briansvr/esp32s3_adc_mini/esp32s3_adc_mini/.step

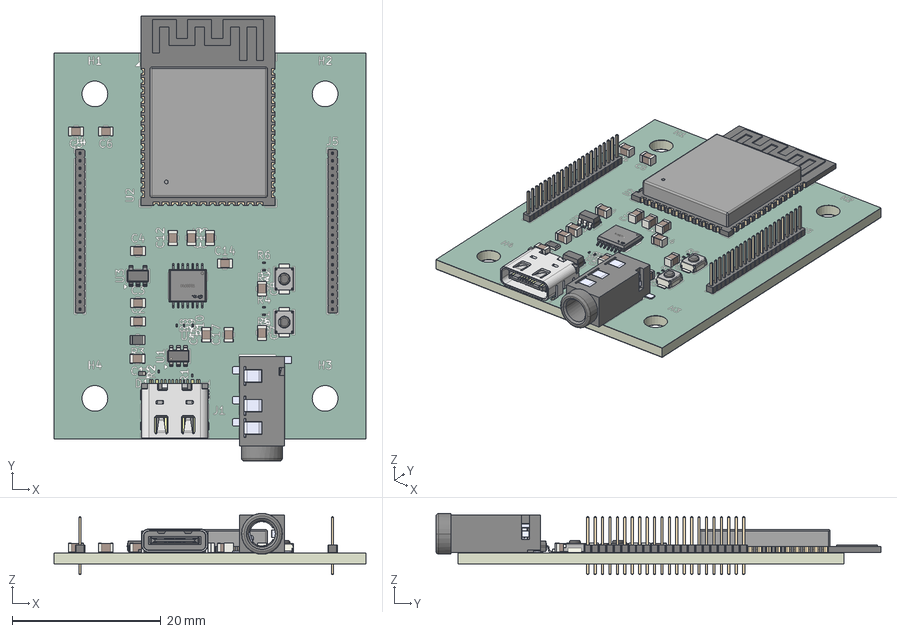
[picture p1: CAD file, 2026-05-14]
esp32s3_adc_mini/.step
42.0 x 59.9 x 8.25 mm
SOT-23-6
R_01005_0402Metric x 9
C_0805_2012Metric x 14
AUDIO-SMD_PJ-320D-1
SW_SPST_B3U-1000P x 2
SOT-23-5
PinHeader_1x22_P1.00mm_Vertical x 2
USB-C-SMD_G-SWITCH_GT-USB-7010ASV
D_SOD-882D
R_0805_2012Metric
TSSOP-14_L5.0-W4.4-H1.0-LS6.4-P0.65
ESP32-S3-WROOM-1
esp32s3_adc_mini_silkscreen
esp32s3_adc_mini_soldermask x 2
esp32s3_adc_mini_PCB
