briansvr/esp32s3_adc_mini/(list of files, cad)

Other CAD files:
esp32s3_adc_mini/.stl
esp32s3_adc_mini_bat/.stl
