briansvr/esp32s3_adc_mini/esp32s3_adc_mini_bat/esp32s3_adc_mini_bat.kicad_pcb

## KiCad design esp32s3_adc_mini_bat/esp32s3_adc_mini_bat.kicad_pcb (2026-09-10)

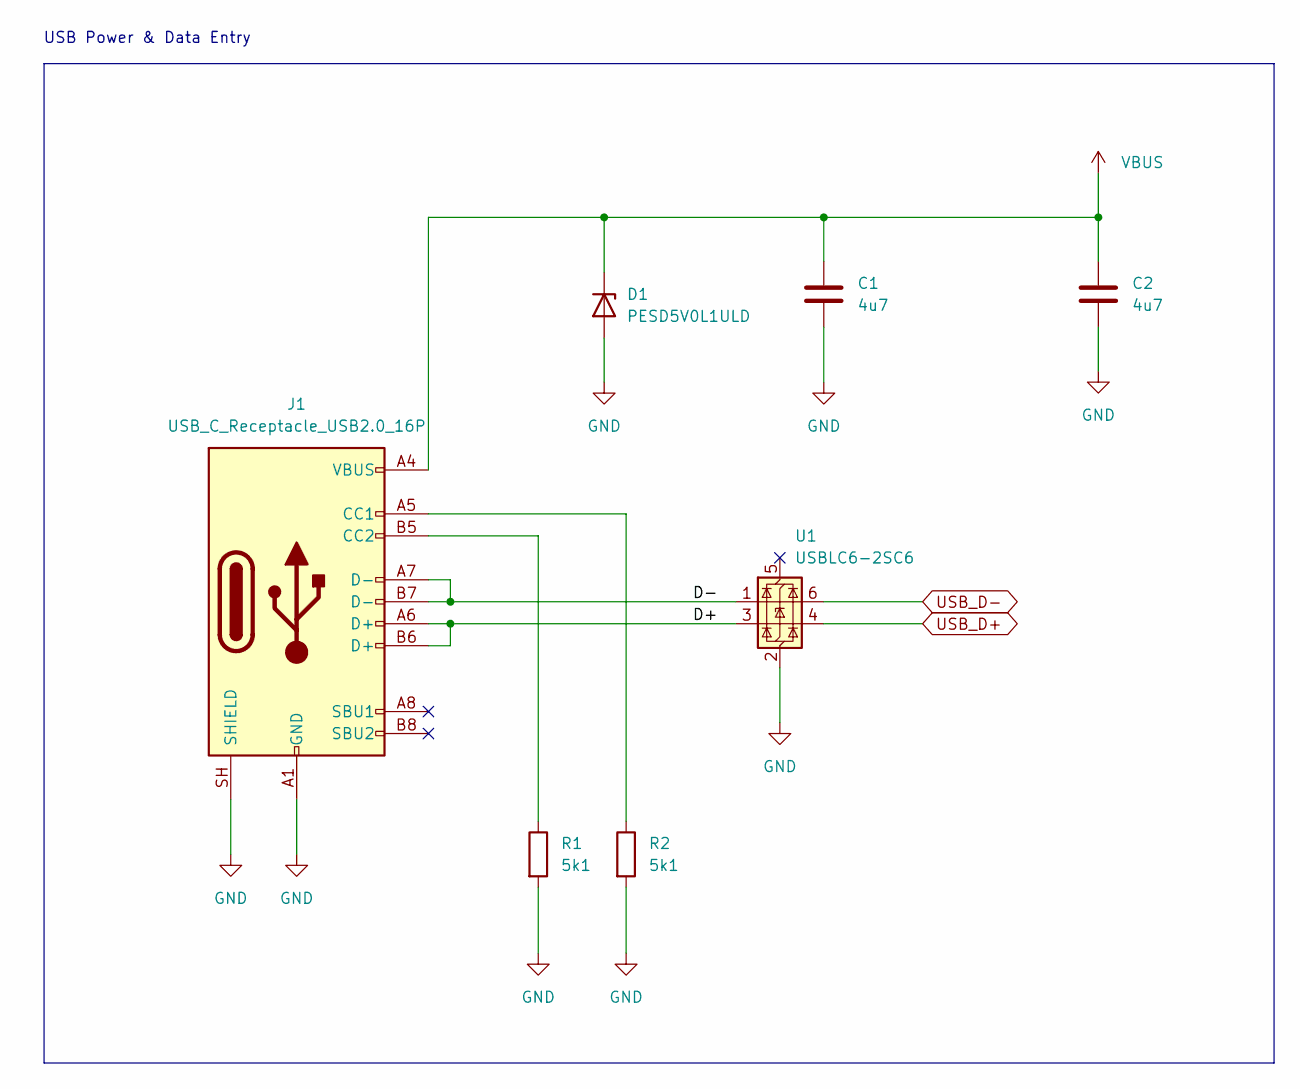
[picture p2: schematic USB_ENTRY.kicad_sch]

Parts:
C1, C2: 4u7; C_0805_2012Metric
D1: PESD5V0L1ULD; D_SOD-882D
J1: USB_C_Receptacle_USB2.0_16P; USB_C_Receptacle_G-Switch_GT-USB-7010ASV
R1, R2: 5k1; R_0402_1005Metric
U1: USBLC6-2SC6; SOT-23-6

Connections:
/USB_ENTRY/D+: J1.A6 (D+), J1.B6 (D+), U1.3 (I/O2)
/USB_ENTRY/D-: J1.A7 (D-), J1.B7 (D-), U1.1 (I/O1)
GND: C1.2, C2.2, D1.2 (A), J1.A1 (GND), J1.A12 (GND), J1.B1 (GND), J1.B12 (GND), J1.SH (SHIELD), R1.2, R2.2, U1.2 (GND); also elsewhere on the board
unnamed: J1.A5 (CC1), R2.1
unnamed: J1.B5 (CC2), R1.1
USB_D+: U1.4 (I/O2); also elsewhere on the board
USB_D-: U1.6 (I/O1); also elsewhere on the board
VBUS: C1.1, C2.1, D1.1 (K), J1.A4 (VBUS), J1.A9 (VBUS), J1.B4 (VBUS), J1.B9 (VBUS); also elsewhere on the board

Notes on the sheet:
USB Power & Data Entry

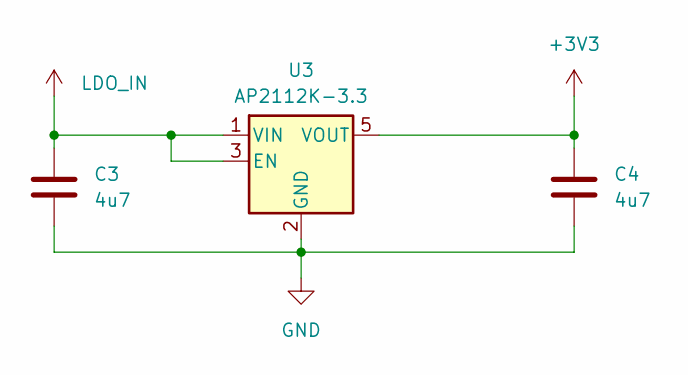
[picture p3: schematic VBUSLDO.kicad_sch]

Parts:
C3, C4: 4u7; C_0805_2012Metric
U3: AP2112K-3.3; SOT-23-5

Connections:
+3V3: C4.1, U3.5 (VOUT); also elsewhere on the board
GND: C3.2, C4.2, U3.2 (GND); also elsewhere on the board
LDO_IN: C3.1, U3.1 (VIN), U3.3 (EN); also elsewhere on the board

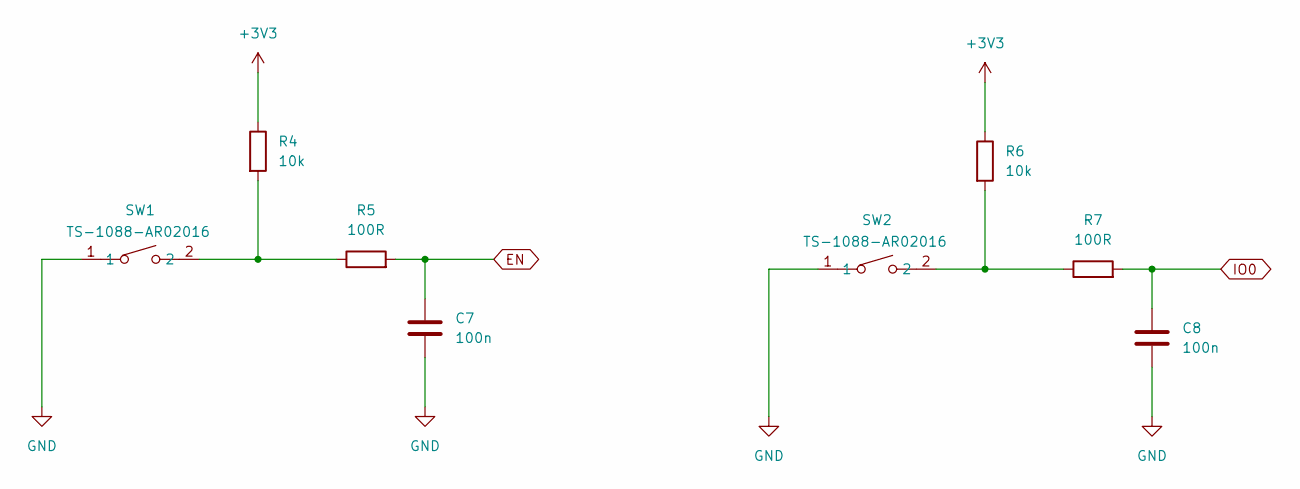
[picture p4: schematic BTNS.kicad_sch]

Parts:
C7, C8: 100n; C_0805_2012Metric
R4, R6: 10k; R_0402_1005Metric
R5, R7: 100R; R_0402_1005Metric
SW1, SW2: TS-1088-AR02016; SW-SMD_L3.9-W3.0-P4.45; MPN TS-1088-AR02016; LCSC Part C720477

Connections:
+3V3: R4.1, R6.1; also elsewhere on the board
EN: C7.1, R5.2; also elsewhere on the board
GND: C7.2, C8.2, SW1.1, SW2.1; also elsewhere on the board
IO0: C8.1, R7.2; also elsewhere on the board
unnamed 47: R4.2, R5.1, SW1.2; also elsewhere on the board
unnamed 48: R6.2, R7.1, SW2.2; also elsewhere on the board

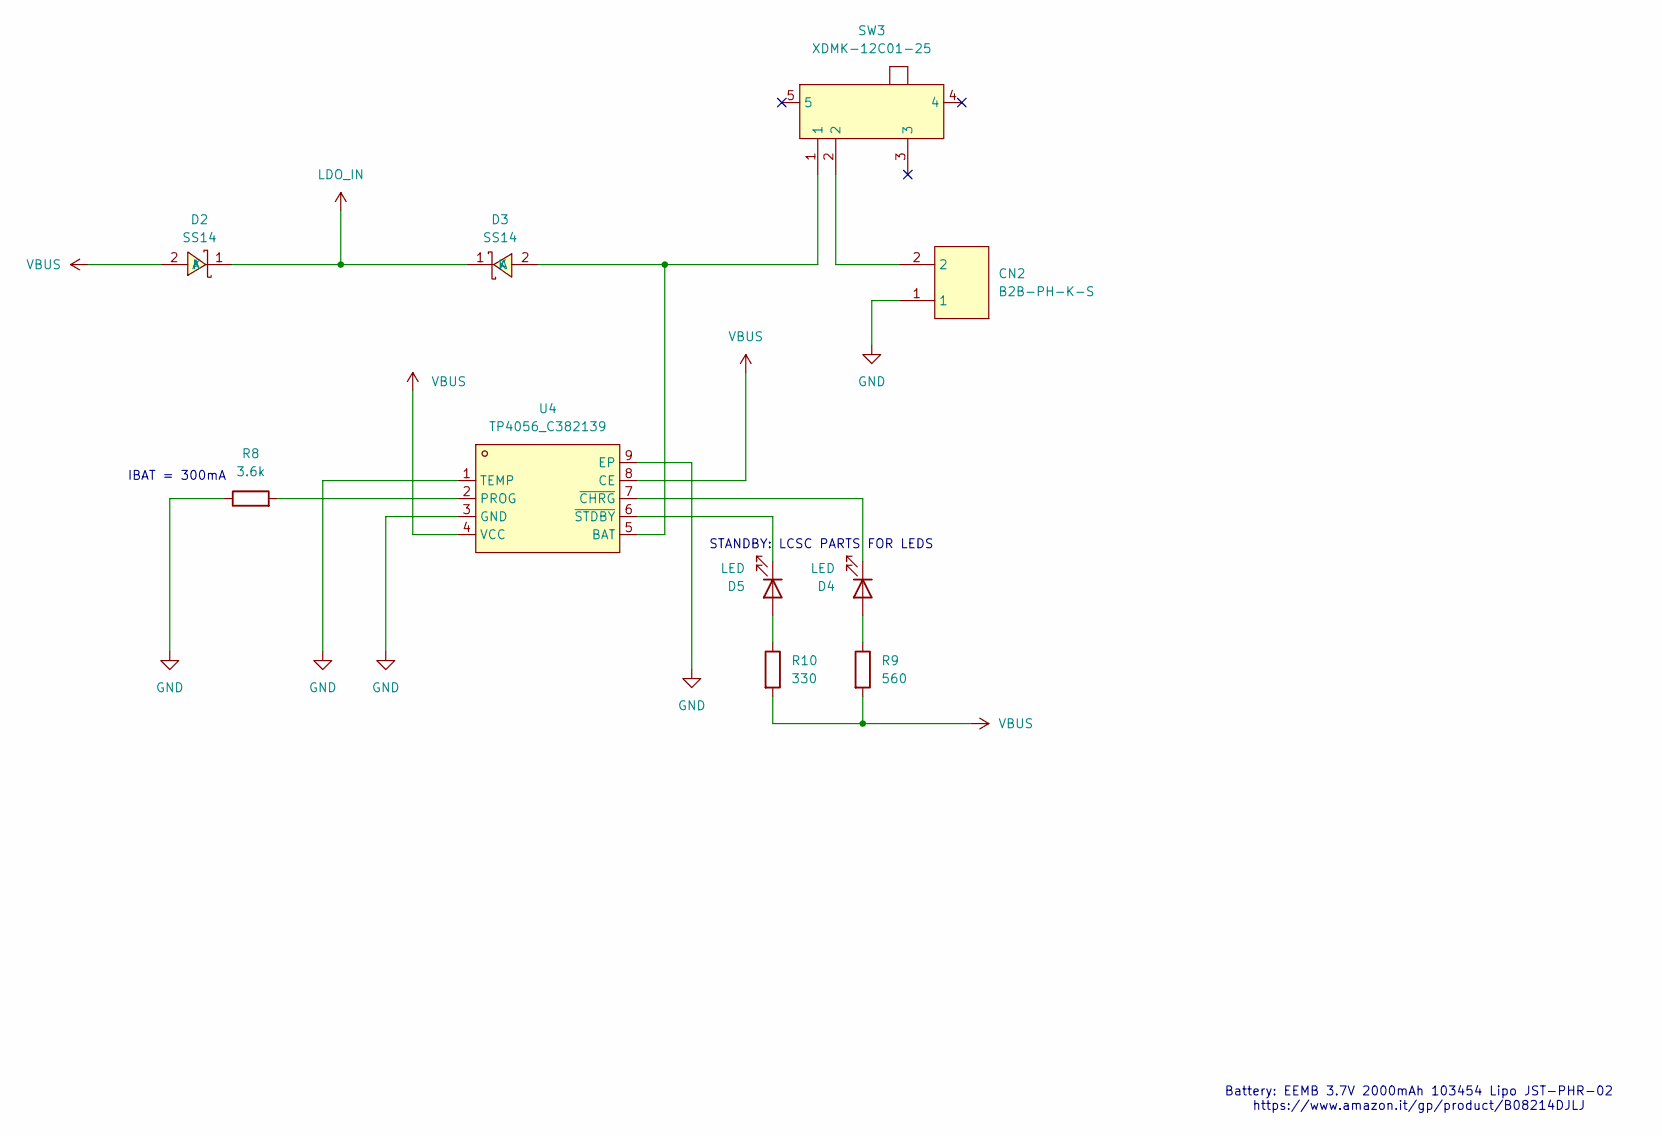
[picture p5: schematic BAT.kicad_sch]

Parts:
CN2: B2B-PH-K-S; CONN-TH_B2B-PH-K-S; MPN B2B-PH-K-S(LF)(SN); LCSC Part C131337
D2, D3: SS14; SMA_L4.2-W2.6-LS5.0-RD_1; MPN SS14; LCSC Part C2480
D4, D5: LED; LED_0402_1005Metric
R8: 3.6k; R_0402_1005Metric
R9: 560; R_0402_1005Metric
R10: 330; R_0402_1005Metric
SW3: XDMK-12C01-25; SW-SMD_XDMK-12C01-25; MPN XDMK-12C01-25; LCSC Part C7498220
U4: TP4056_C382139; ESOP-8_L4.9-W3.9-P1.27-LS6.0-BL-EP; MPN TP4056; LCSC Part C382139

Connections:
GND: CN2.1, R8.1, U4.1 (TEMP), U4.3 (GND), U4.9 (EP); also elsewhere on the board
LDO_IN: D2.1 (K), D3.1 (K); also elsewhere on the board
unnamed 39: CN2.2, SW3.2; also elsewhere on the board
unnamed 40: D3.2 (A), SW3.1, U4.5 (BAT); also elsewhere on the board
unnamed: D4.2 (A), R9.1
unnamed: D4.1 (K), U4.7 (~CHRG)
unnamed: D5.2 (A), R10.1
unnamed: D5.1 (K), U4.6 (~STDBY)
unnamed: R8.2, U4.2 (PROG)
VBUS: D2.2 (A), R9.2, R10.2, U4.4 (VCC), U4.8 (CE); also elsewhere on the board

Notes on the sheet:
IBAT = 300mA
Battery: EEMB 3.7V 2000mAh 103454 Lipo JST-PHR-02 https://www.amazon.it/gp/product/B08214DJLJ
STANDBY: LCSC PARTS FOR LEDS

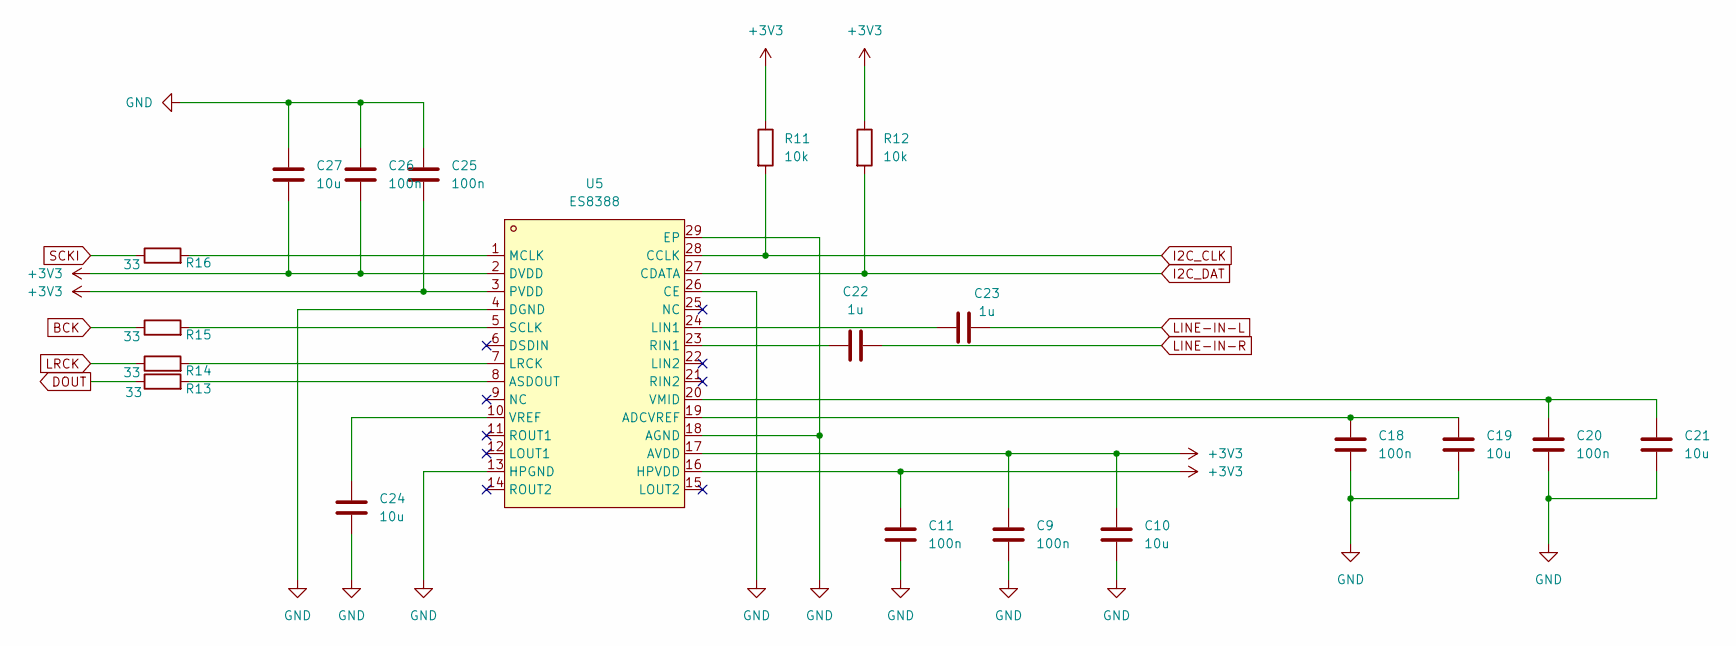
[picture p6: schematic CODEC.kicad_sch]

Parts:
C9, C11, C18, C20, C25, C26: 100n; C_0402_1005Metric
C10, C19, C21, C24, C27: 10u; C_0603_1608Metric
C22, C23: 1u; C_0805_2012Metric
R11, R12: 10k; R_0402_1005Metric
R13, R14, R15, R16: 33; R_0402_1005Metric
U5: ES8388; QFN-28_L4.0-W4.0-P0.45-BL-EP; MPN ES8388; LCSC Part C365736

Connections:
+3V3: C9.1, C10.1, C11.1, C25.2, C26.2, C27.2, R11.1, R12.1, U5.2 (DVDD), U5.3 (PVDD), U5.16 (HPVDD), U5.17 (AVDD); also elsewhere on the board
BCK: R15.1; also elsewhere on the board
DOUT: R13.1; also elsewhere on the board
GND: C9.2, C10.2, C11.2, C18.2, C19.2, C20.2, C21.2, C24.2, C25.1, C26.1, C27.1, U5.4 (DGND), U5.13 (HPGND), U5.18 (AGND), U5.26 (CE), U5.29 (EP); also elsewhere on the board
I2C_CLK: R11.2, U5.28 (CCLK); also elsewhere on the board
I2C_DAT: R12.2, U5.27 (CDATA); also elsewhere on the board
LINE-IN-L: C23.1; also elsewhere on the board
LINE-IN-R: C22.1; also elsewhere on the board
LRCK: R14.1; also elsewhere on the board
unnamed: C18.1, C19.1, U5.19 (ADCVREF)
unnamed: R13.2, U5.8 (ASDOUT)
unnamed: C23.2, U5.24 (LIN1)
unnamed: R14.2, U5.7 (LRCK)
unnamed: R16.2, U5.1 (MCLK)
unnamed: C22.2, U5.23 (RIN1)
unnamed: R15.2, U5.5 (SCLK)
unnamed: C20.1, C21.1, U5.20 (VMID)
unnamed: C24.1, U5.10 (VREF)
SCKI: R16.1; also elsewhere on the board

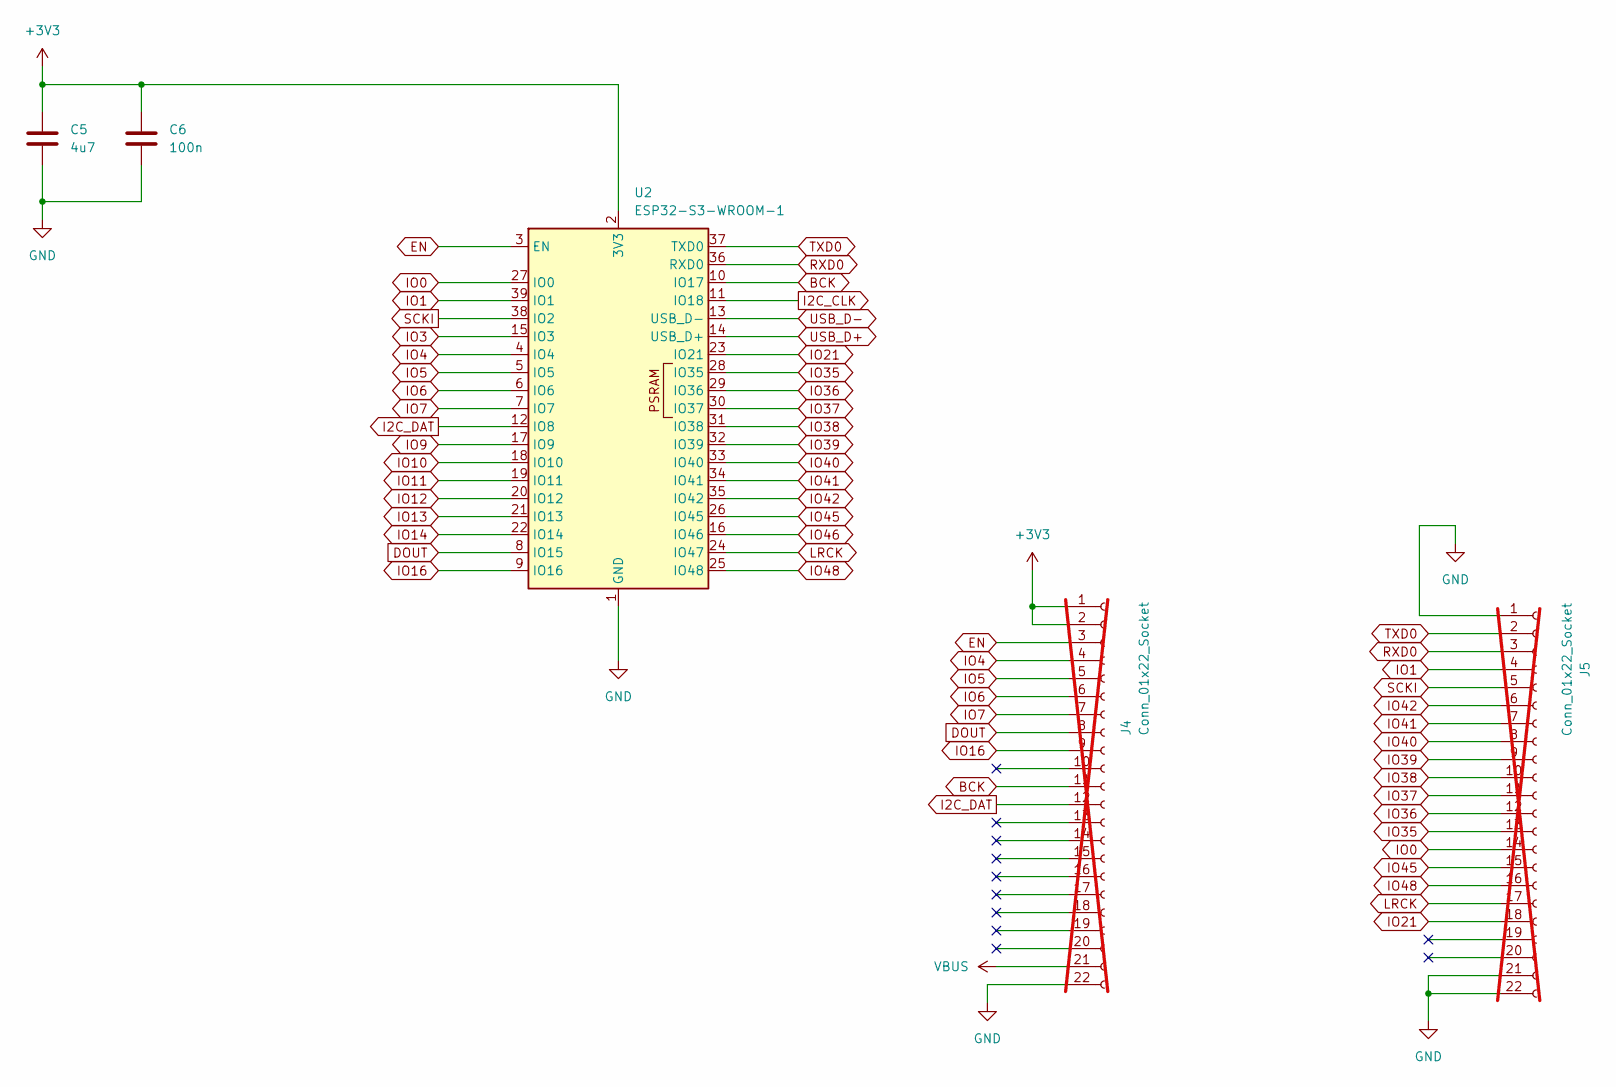
[picture p7: schematic ESP32S3WROOM1.kicad_sch]

Parts:
C5: 4u7; C_0805_2012Metric
C6: 100n; C_0805_2012Metric
J4, J5: Conn_01x22_Socket; PinHeader_1x22_P1.00mm_Vertical; not fitted
U2: ESP32-S3-WROOM-1

Connections:
+3V3: C5.1, C6.1, J4.1, J4.2, U2.2 (3V3); also elsewhere on the board
BCK: J4.11, U2.10 (IO17); also elsewhere on the board
DOUT: J4.8, U2.8 (IO15); also elsewhere on the board
EN: J4.3, U2.3 (EN); also elsewhere on the board
GND: C5.2, C6.2, J4.22, J5.1, J5.21, J5.22, U2.1 (GND), U2.40 (GND), U2.41 (GND); also elsewhere on the board
I2C_CLK: U2.11 (IO18); also elsewhere on the board
I2C_DAT: J4.12, U2.12 (IO8); also elsewhere on the board
IO0: J5.14, U2.27 (IO0); also elsewhere on the board
IO1: J5.4, U2.39 (IO1)
IO3: U2.15 (IO3)
IO4: J4.4, U2.4 (IO4)
IO5: J4.5, U2.5 (IO5)
IO6: J4.6, U2.6 (IO6)
IO7: J4.7, U2.7 (IO7)
IO9: U2.17 (IO9)
IO10: U2.18 (IO10)
IO11: U2.19 (IO11)
IO12: U2.20 (IO12)
IO13: U2.21 (IO13)
IO14: U2.22 (IO14)
IO16: J4.9, U2.9 (IO16)
IO21: J5.18, U2.23 (IO21)
IO35: J5.13, U2.28 (IO35)
IO36: J5.12, U2.29 (IO36)
IO37: J5.11, U2.30 (IO37)
IO38: J5.10, U2.31 (IO38)
IO39: J5.9, U2.32 (IO39)
IO40: J5.8, U2.33 (IO40)
IO41: J5.7, U2.34 (IO41)
IO42: J5.6, U2.35 (IO42)
IO45: J5.15, U2.26 (IO45)
IO46: U2.16 (IO46)
IO48: J5.16, U2.25 (IO48)
LRCK: J5.17, U2.24 (IO47); also elsewhere on the board
RXD0: J5.3, U2.36 (RXD0)
SCKI: J5.5, U2.38 (IO2); also elsewhere on the board
TXD0: J5.2, U2.37 (TXD0)
USB_D+: U2.14 (USB_D+); also elsewhere on the board
USB_D-: U2.13 (USB_D-); also elsewhere on the board
VBUS: J4.21; also elsewhere on the board

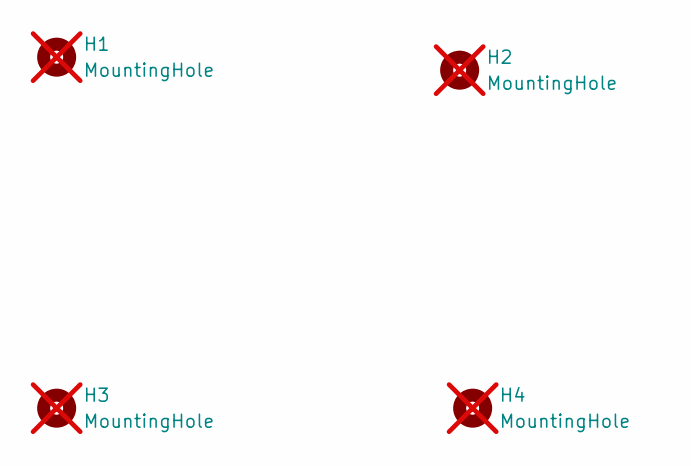
[picture p8: schematic FIXINGHOLES.kicad_sch]

Parts:
H1, H2, H3, H4: MountingHole; MountingHole_3.5mm; not fitted

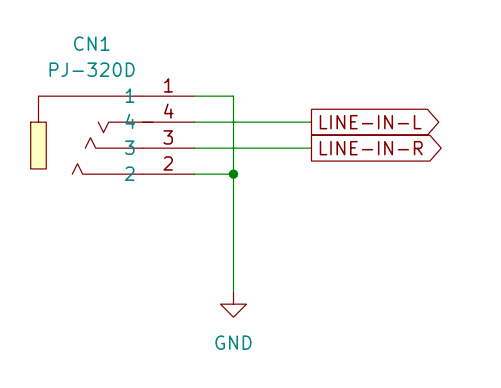
[picture p9: schematic LINEIN.kicad_sch]

Parts:
CN1: PJ-320D; AUDIO-SMD_PJ-320D-1; MPN PJ-320D; LCSC Part C431535

Connections:
GND: CN1.1, CN1.2; also elsewhere on the board
LINE-IN-L: CN1.4; also elsewhere on the board
LINE-IN-R: CN1.3; also elsewhere on the board

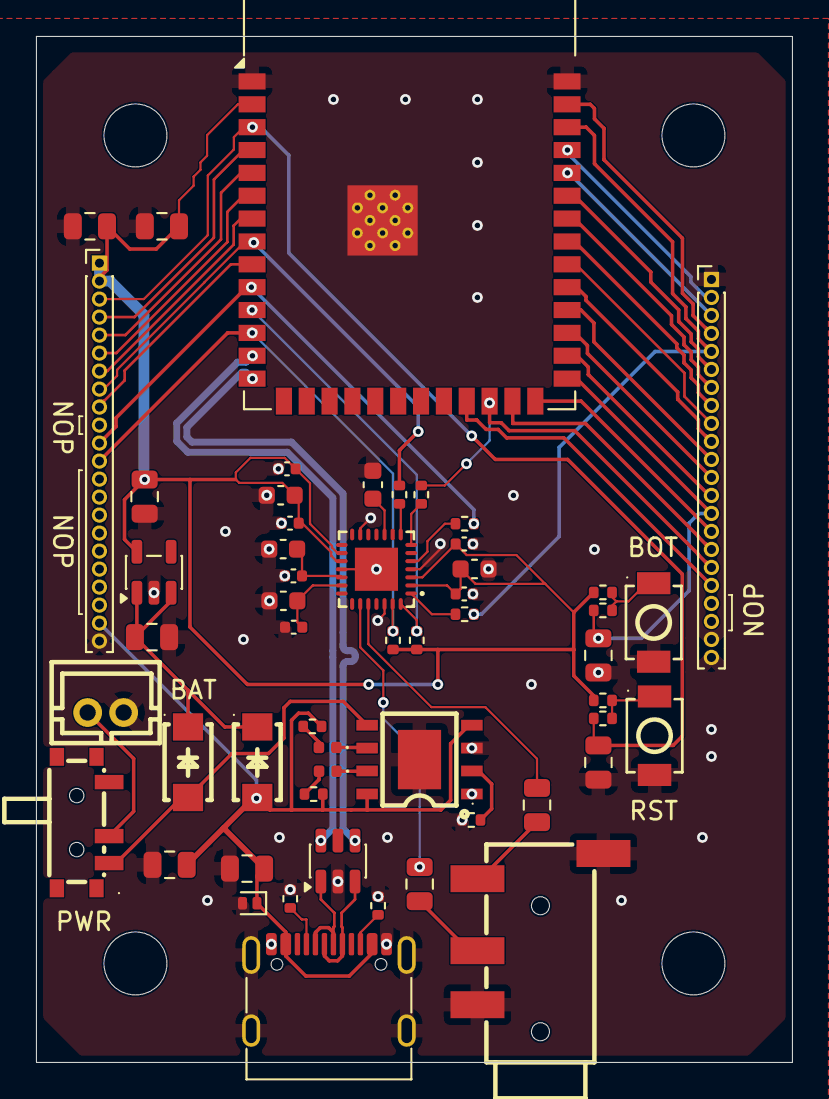
[picture p10: board esp32s3_adc_mini_bat.kicad_pcb from above]

Board: 2 copper layers, 42.0 x 57.0 mm, 58 parts (0 on the bottom side), 57 nets.

Other parts of the board:
BAT: B2B-PH-K-S; CONN-TH_B2B-PH-K-S
BOT: TS-1088-AR02016; SW-SMD_L3.9-W3.0-P4.45
PWR: XDMK-12C01-25; SW-SMD_XDMK-12C01-25
RST: TS-1088-AR02016; SW-SMD_L3.9-W3.0-P4.45

Their connections:
GND: BAT.1, BOT.1, RST.1; also elsewhere on the board
unnamed 39: BAT.2, PWR.2; also elsewhere on the board
unnamed 40: PWR.1; also elsewhere on the board
unnamed 47: RST.2; also elsewhere on the board
unnamed 48: BOT.2; also elsewhere on the board
