briansvr/esp32s3_adc_mini/(commit log)

2026-05-14 chore: init
    [.step, .stl, ADC.kicad_sch, BTNS.kicad_sch, ESP32S3WROOM1.kicad_sch, FIXINGHOLES.kicad_sch, HEADERS.kicad_sch, LINEIN.kicad_sch]
2026-05-15 feat: ES8388
    [ADC.kicad_sch, BTNS.kicad_sch, CODEC.kicad_sch, ESP32S3WROOM1.kicad_sch, FIXINGHOLES.kicad_sch, LINEIN.kicad_sch, USB_ENTRY.kicad_sch, VBUSLDO.kicad_sch]
2026-05-15 feat: schematic done and pcb grouping
    [BAT.kicad_sch, CODEC.kicad_sch, ESP32S3WROOM1.kicad_sch, USB_ENTRY.kicad_sch, VBUSLDO.kicad_sch, esp32s3_adc_mini_bat.kicad_pcb, esp32s3_adc_mini_bat.kicad_sch]
2026-09-08 chore: silk screen cleanup and DRC pass
    [BAT.kicad_sch, CODEC.kicad_sch, ESP32S3WROOM1.kicad_sch, FIXINGHOLES.kicad_sch, USB_ENTRY.kicad_sch, VBUSLDO.kicad_sch, esp32s3_adc_mini_bat.kicad_pcb]
2026-09-08 chore: minor changes
    [BOM-esp32s3_adc_mini_bat.csv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]
2026-09-10 chore: jlcpcb gerber update and battery size update
    [BOM-esp32s3_adc_mini_bat.csv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]
